RobertoSandoval27/Solar-Powered-Environmental-Monitoring-System/hardware/BOM.md

# Bill of Materials (BOM)

| Component | Qty | Approx. Cost | Purpose |
|---|-----|---|---|
| HiLetgo ESP32 DevKitC | 1 | $6.00 | Main controller |
| HC-SR501 PIR Sensor | 1 | $2.00 | Occupancy detection |
| BME280 Temperature Sensor | 1 | $6.50 | Temperature monitoring |
| Arctic P12 Pro - 120 mm PWM Fan | 1 | $8.50 | Ventilation |
| MOSFET Module - IRLZ44N | 1 | $1.00 | Fan switching |
| LM2596 Buck Converter | 1 | $1.60 | 12V to 5V conversion |
| SOLPERK - 20W 12V Solar Panel Kit | 1 | $33.00 | Solar power generation |
| 12V 10Ah LiFePO4 Battery | 1 | $36 | Energy storage |
| 18 AWG Stranded Wire - 30ft | 1 | $17.00 | Power wiring |
| 5A Inline Fuse | 1 | $1.50 | Battery protection |

## Total Project Cost

Purchased Components: ~$113

Previously Owned Components:
- 12V 10Ah LiFePO4 Battery
- 5A Inline Fuse
- Wire Strippers/Cutters
- 22 AWG Solid Core Wire

## Notes

This BOM will be updated as additional components are integrated and tested.
