RobertoSandoval27/Solar-Powered-Environmental-Monitoring-System/code/pir_test/pir_test.ino

const int PIR_PIN = 4;

void setup() {
  Serial.begin(115200);
  pinMode(PIR_PIN, INPUT);

  Serial.println("PIR Test Started");
}

void loop() {
  int motion = digitalRead(PIR_PIN);

  if (motion == HIGH) {
    Serial.println("Motion Detected");
  } else {
    Serial.println("No Motion");
  }

  delay(500);
}
