RobertoSandoval27/Solar-Powered-Environmental-Monitoring-System/code/bme280_test/i2c_scanner.ino

#include <Wire.h>

void setup() {
  Serial.begin(115200);
  delay(1000);

  Wire.begin(21, 22);   // SDA = GPIO21, SCL = GPIO22

  Serial.println();
  Serial.println("I2C Scanner");
}

void loop() {
  byte error, address;
  int devices = 0;

  Serial.println("Scanning...");

  for (address = 1; address < 127; address++) {

    Wire.beginTransmission(address);
    error = Wire.endTransmission();

    if (error == 0) {
      Serial.print("I2C device found at 0x");

      if (address < 16)
        Serial.print("0");

      Serial.println(address, HEX);
      devices++;
    }
  }

  if (devices == 0) {
    Serial.println("No I2C devices found");
  }

  Serial.println();
  delay(5000);
}
