RobertoSandoval27/Solar-Powered-Environmental-Monitoring-System/(commit log)

2026-06-21 ESP32 verification
2026-06-23 Add BME280 sensor test documentation
2026-06-23 Add ESP32 pinout reference diagram
2026-06-23 Add ESP32 pinout reference to BME280 test
2026-06-23 Add BME280 sensor test sketch
2026-06-23 Add I2C scanner diagnostic sketch
2026-06-23 Updated status, BME280 temp sensor integrated
2026-06-24 PIR sensor reference diagram
2026-06-24 Constructed README.md for PIR sensor
2026-06-24 Updated current status, PIR sensor milestone
2026-07-10 Create README.md, Fan control test
2026-07-10 Add MOSFET reference diagram
2026-07-12 Update README.md, temperature_control
2026-07-16 Create README.md for PIR sensor
2026-07-17 Create README.md, power system architecture (planning)
2026-07-18 Create README.md, battery integration
2026-07-19 Create README.md, battery voltage monitoring
2026-07-19 Update README.md, battery monitor
